lologog/TempControlBox/README.md

# TempControlBox - 🚧 Work in Progress
Device for testing control algorithms and system identification
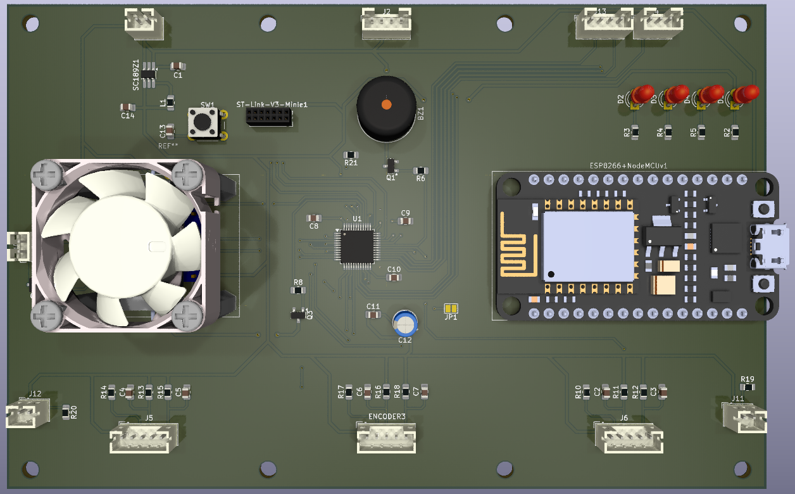
[picture p1: Images/TempControlBox-3D.png]

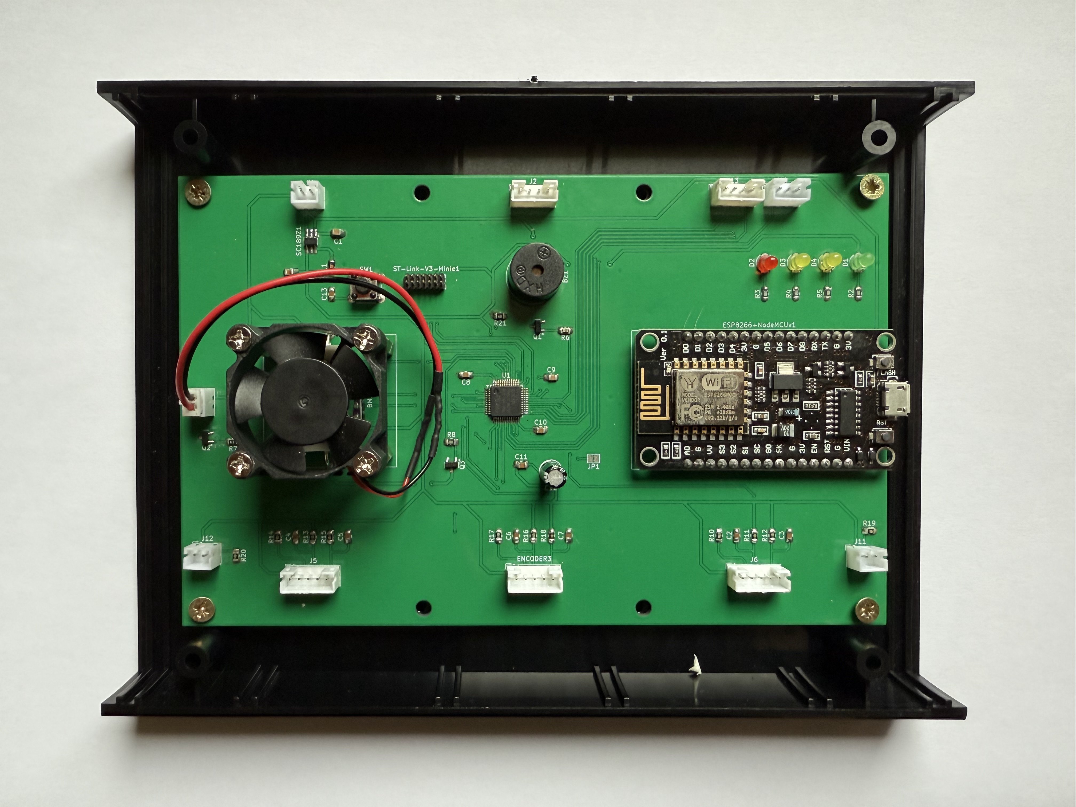
[picture p2: Images/TempControlBox-PCB.jpg]

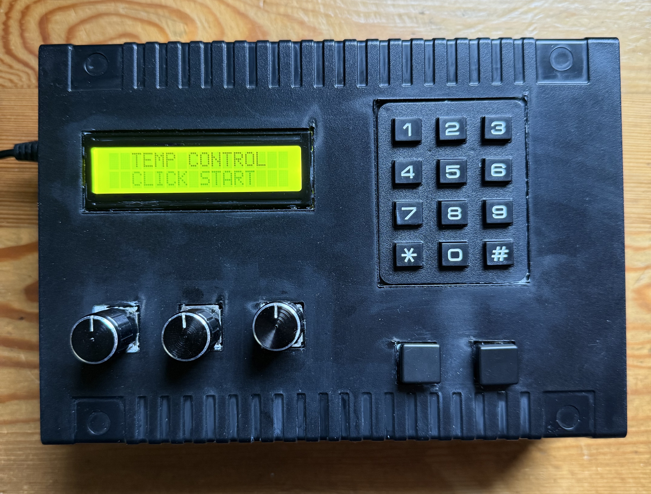
[picture p3: Images/TempControlBox-Assembled.jpg]
