lologog/TempControlBox/PCB/PID_TEMPERATURE_KICAD.kicad_pcb

## KiCad design PCB/PID_TEMPERATURE_KICAD.kicad_pcb (2025-03-09)

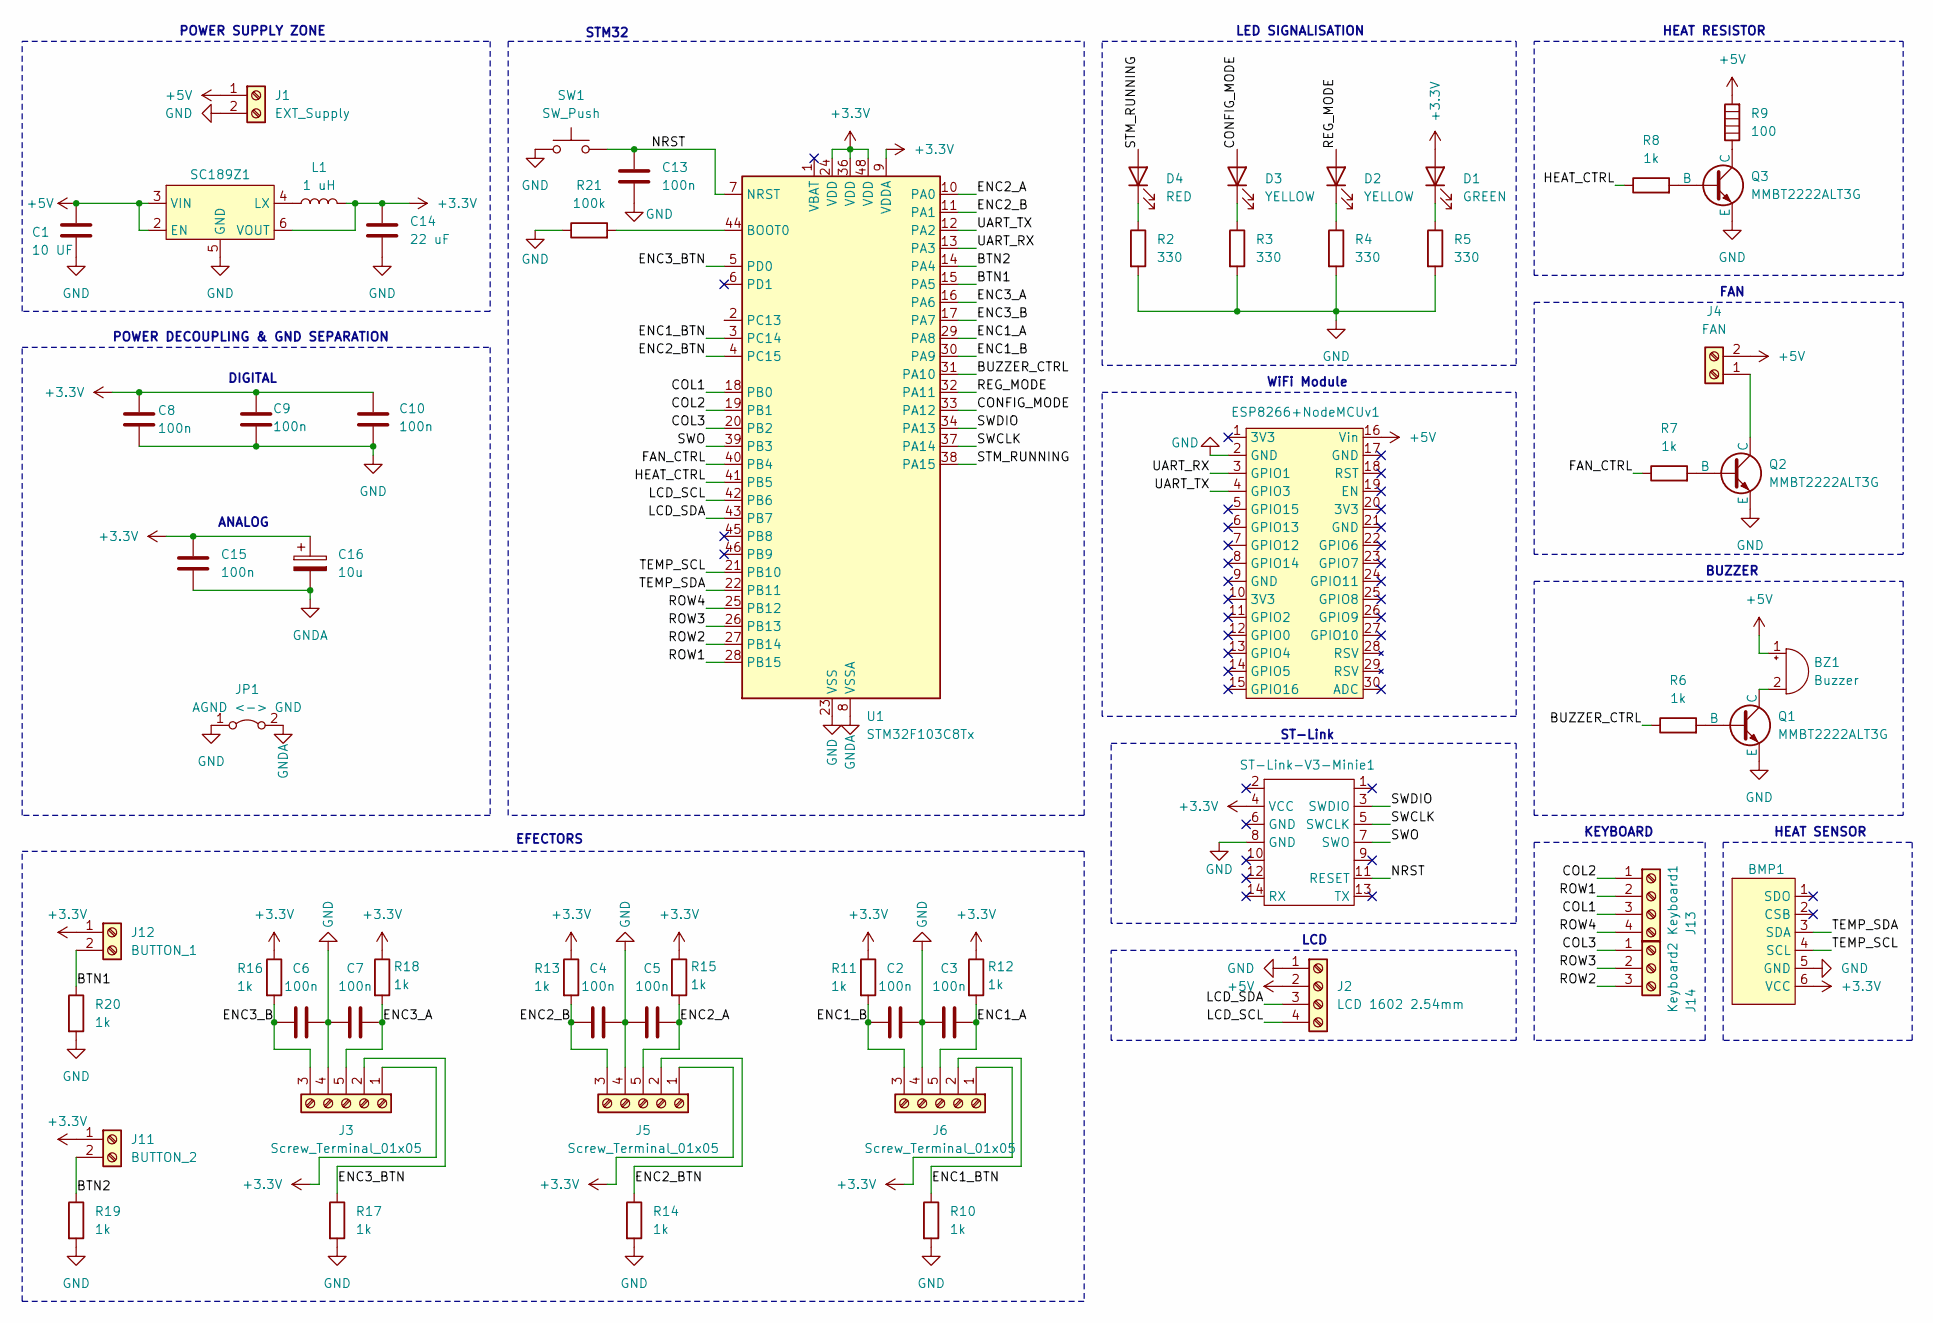
[picture p4: schematic PID_TEMPERATURE_KICAD.kicad_sch, TempControlBox]

Parts:
BMP1: BMP280
BZ1: Buzzer; Buzzer_12x9.5RM7.6
C1: 10 UF; C_0805_2012Metric_Pad1.18x1.45mm_HandSolder
C2, C3, C4, C5, C6, C7, C8, C9, C10, C13, C15: 100n; C_0805_2012Metric_Pad1.18x1.45mm_HandSolder
C14: 22 uF; C_0805_2012Metric_Pad1.18x1.45mm_HandSolder
C16: 10u; CP_Radial_D5.0mm_P2.50mm
D1: GREEN; LED_D3.0mm
D2, D3: YELLOW; LED_D3.0mm
D4: RED; LED_D3.0mm
ESP8266+NodeMCUv1: NodeMCU
J1: EXT_Supply; JST_PH_B2B-PH-K_1x02_P2.00mm_Vertical
J2: LCD 1602 2.54mm; JST_PH_B4B-PH-K_1x04_P2.00mm_Vertical
J3, J5, J6: Screw_Terminal_01x05; JST_PH_B5B-PH-K_1x05_P2.00mm_Vertical
J4: FAN; JST_PH_B2B-PH-K_1x02_P2.00mm_Vertical
J11: BUTTON_2; JST_PH_B2B-PH-K_1x02_P2.00mm_Vertical
J12: BUTTON_1; JST_PH_B2B-PH-K_1x02_P2.00mm_Vertical
J13: Keyboard1; JST_PH_B4B-PH-K_1x04_P2.00mm_Vertical
J14: Keyboard2; JST_PH_B3B-PH-K_1x03_P2.00mm_Vertical
JP1: AGND <-> GND; SolderJumper-2_P1.3mm_Bridged2Bar_Pad1.0x1.5mm
L1: 1 uH; R_0805_2012Metric_Pad1.20x1.40mm_HandSolder
Q1, Q2, Q3: MMBT2222ALT3G; SOT-23
R2, R3, R4, R5: 330; R_0805_2012Metric_Pad1.20x1.40mm_HandSolder
R6, R7, R8, R10, R11, R12, R13, R14, R15, R16, R17, R18, R19, R20: 1k; R_0805_2012Metric_Pad1.20x1.40mm_HandSolder
R9: 100; Heat_Resistor
R21: 100k; R_0805_2012Metric_Pad1.20x1.40mm_HandSolder
SC189Z1: TSOT-23-6_HandSoldering
ST-Link-V3-Minie1: PinSocket_2x07_P1.27mm_Vertical
SW1: SW_Push; SW_PUSH_6mm_H4.3mm
U1: STM32F103C8Tx; LQFP-48_7x7mm_P0.5mm

Connections:
+3.3V: BMP1.6 (VCC), C8.1, C9.1, C10.1, C14.1, C15.1, C16.1, D1.2 (A), J3.1, J5.1, J6.1, J11.1, J12.1, L1.2, R11.1, R12.1, R13.1, R15.1, R16.1, R18.1, SC189Z1.6 (VOUT), ST-Link-V3-Minie1.4 (VCC), U1.9 (VDDA), U1.24 (VDD), U1.36 (VDD), U1.48 (VDD)
+5V: BZ1.1 (+), C1.1, ESP8266+NodeMCUv1.16 (Vin), J1.1, J2.2, J4.2, R9.2, SC189Z1.2 (EN), SC189Z1.3 (VIN)
/BTN1: J12.2, R20.1, U1.15 (PA5)
/BTN2: J11.2, R19.1, U1.14 (PA4)
/BUZZER_CTRL: R6.1, U1.31 (PA10)
/COL1: J13.3, U1.18 (PB0)
/COL2: J13.1, U1.19 (PB1)
/COL3: J14.1, U1.20 (PB2)
/CONFIG_MODE: D3.2 (A), U1.33 (PA12)
/ENC1_A: C3.2, J6.5 (Pin_3), R12.2, U1.29 (PA8)
/ENC1_B: C2.1, J6.3 (Pin_5), R11.2, U1.30 (PA9)
/ENC1_BTN: J6.2, R10.1, U1.3 (PC14)
/ENC2_A: C5.2, J5.5 (Pin_3), R15.2, U1.10 (PA0)
/ENC2_B: C4.1, J5.3 (Pin_5), R13.2, U1.11 (PA1)
/ENC2_BTN: J5.2, R14.1, U1.4 (PC15)
/ENC3_A: C7.2, J3.5 (Pin_3), R18.2, U1.16 (PA6)
/ENC3_B: C6.1, J3.3 (Pin_5), R16.2, U1.17 (PA7)
/ENC3_BTN: J3.2, R17.1, U1.5 (PD0)
/FAN_CTRL: R7.1, U1.40 (PB4)
/HEAT_CTRL: R8.1, U1.41 (PB5)
/LCD_SCL: J2.4, U1.42 (PB6)
/LCD_SDA: J2.3, U1.43 (PB7)
/NRST: C13.1, ST-Link-V3-Minie1.11 (RESET), SW1.2, U1.7 (NRST)
/REG_MODE: D2.2 (A), U1.32 (PA11)
/ROW1: J13.2, U1.28 (PB15)
/ROW2: J14.3, U1.27 (PB14)
/ROW3: J14.2, U1.26 (PB13)
/ROW4: J13.4, U1.25 (PB12)
/STM_RUNNING: D4.2 (A), U1.38 (PA15)
/SWCLK: ST-Link-V3-Minie1.5 (SWCLK), U1.37 (PA14)
/SWDIO: ST-Link-V3-Minie1.3 (SWDIO), U1.34 (PA13)
/SWO: ST-Link-V3-Minie1.7 (SWO), U1.39 (PB3)
/TEMP_SCL: BMP1.4 (SCL), U1.21 (PB10)
/TEMP_SDA: BMP1.3 (SDA), U1.22 (PB11)
/UART_RX: ESP8266+NodeMCUv1.3 (GPIO1), U1.13 (PA3)
/UART_TX: ESP8266+NodeMCUv1.4 (GPIO3), U1.12 (PA2)
GND: BMP1.5 (GND), C1.2, C2.2, C3.1, C4.2, C5.1, C6.2, C7.1, C8.2, C9.2, C10.2, C13.2, C14.2, ESP8266+NodeMCUv1.2 (GND), J1.2, J2.1, J3.4, J5.4, J6.4, JP1.1 (A), Q1.2 (E), Q2.2 (E), Q3.2 (E), R2.2, R3.2, R4.2, R5.2, R10.2, R14.2, R17.2, R19.2, R20.2, R21.1, SC189Z1.5 (GND), ST-Link-V3-Minie1.8 (GND), SW1.1, U1.23 (VSS), U1.35 (VSS), U1.47 (VSS)
GNDA: C15.2, C16.2, JP1.2 (B), U1.8 (VSSA)
unnamed: BZ1.2 (-), Q1.3 (C)
unnamed: D1.1 (K), R5.1
unnamed: D2.1 (K), R4.1
unnamed: D3.1 (K), R3.1
unnamed: D4.1 (K), R2.1
unnamed: J4.1, Q2.3 (C)
unnamed: Q1.1 (B), R6.2
unnamed: Q2.1 (B), R7.2
unnamed: Q3.1 (B), R8.2
unnamed: Q3.3 (C), R9.1
unnamed: L1.1, SC189Z1.4 (LX)
unnamed: R21.2, U1.44 (BOOT0)

Notes on the sheet:
HEAT RESISTOR
ST-Link
EFECTORS
LCD
HEAT SENSOR
POWER DECOUPLING & GND SEPARATION
WiFi Module
BUZZER
ANALOG
STM32
LED SIGNALISATION
FAN
KEYBOARD
DIGITAL
POWER SUPPLY ZONE

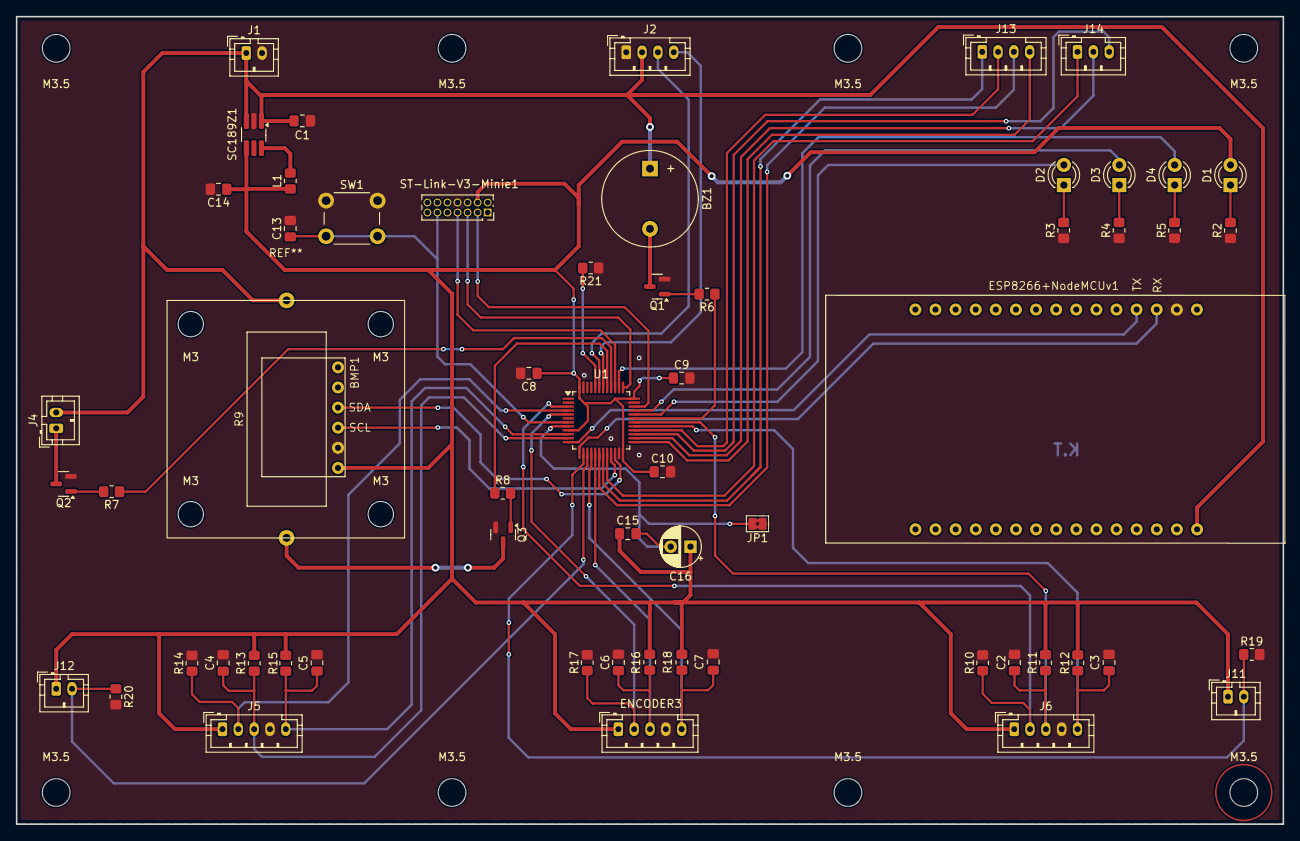
[picture p5: board PID_TEMPERATURE_KICAD.kicad_pcb from above]

Board: 2 copper layers, 160.0 x 102.0 mm, 72 parts (0 on the bottom side), 50 nets.

Other parts of the board:
M3, M3#2, M3#3, M3#4: MountingHole_3.2mm_M3
M3.5, M3.5#2, M3.5#3, M3.5#4, M3.5#5, M3.5#6, M3.5#7, M3.5#8: MountingHole_3.5mm
