lologog/TempControlBox/Firmware/STM32/Core/Src/main.c

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
/* Includes ------------------------------------------------------------------*/
#include "main.h"

/* USER CODE BEGIN Includes */
#include "lcd1602.h"
#include "keyboard.h"
#include "tempsensor.h"
#include "logic.h"
/* USER CODE END Includes */

I2C_HandleTypeDef hi2c1;
I2C_HandleTypeDef hi2c2;

TIM_HandleTypeDef htim1;
TIM_HandleTypeDef htim2;
TIM_HandleTypeDef htim3;

UART_HandleTypeDef huart2;

void SystemClock_Config(void);
static void MX_GPIO_Init(void);
static void MX_I2C1_Init(void);
static void MX_TIM1_Init(void);
static void MX_TIM2_Init(void);
static void MX_TIM3_Init(void);
static void MX_I2C2_Init(void);
static void MX_USART2_UART_Init(void);
/* USER CODE BEGIN 0 */
void HAL_GPIO_EXTI_Callback(uint16_t GPIO_Pin)
{
    if (GPIO_Pin == BTN2_Pin)
    {
        NVIC_SystemReset(); // Reset the system
    }
}
/* USER CODE END 0 */

/**
  * @brief  The application entry point.
  * @retval int
  */
int main(void)
{

  /* MCU Configuration--------------------------------------------------------*/

  /* Reset of all peripherals, Initializes the Flash interface and the Systick. */
  HAL_Init();

  /* Configure the system clock */
  SystemClock_Config();

  /* Initialize all configured peripherals */
  MX_GPIO_Init();
  MX_I2C1_Init();
  MX_TIM1_Init();
  MX_TIM2_Init();
  MX_TIM3_Init();
  MX_I2C2_Init();
  MX_USART2_UART_Init();
  /* USER CODE BEGIN 2 */
  //initialization of the peripherials and its necessaries
  HAL_TIM_Encoder_Start(&htim1, TIM_CHANNEL_ALL);
  HAL_TIM_Encoder_Start(&htim2, TIM_CHANNEL_ALL);
  HAL_TIM_Encoder_Start(&htim3, TIM_CHANNEL_ALL);
  TempSensor_Init(&hi2c2);
  LCD_Init(&hi2c1);

  //turn on the LED that shows that STM is working
  HAL_GPIO_WritePin(STM_RUNNING_GPIO_Port, STM_RUNNING_Pin, GPIO_PIN_SET);

  /* USER CODE END 2 */

  /* Infinite loop */
  /* USER CODE BEGIN WHILE */
  while (1)
  {
    stateMachine();
    /* USER CODE END WHILE */

    /* USER CODE BEGIN 3 */
  }
  /* USER CODE END 3 */
}

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
