lologog/TempControlBox/Firmware/STM32/Core/Inc/main.h

#define ENC1_BTN_Pin GPIO_PIN_14
#define ENC1_BTN_GPIO_Port GPIOC
#define ENC2_BTN_Pin GPIO_PIN_15
#define ENC2_BTN_GPIO_Port GPIOC
#define ENC3_BTN_Pin GPIO_PIN_0
#define ENC3_BTN_GPIO_Port GPIOD
#define ENC2_A_Pin GPIO_PIN_0
#define ENC2_A_GPIO_Port GPIOA
#define ENC2_B_Pin GPIO_PIN_1
#define ENC2_B_GPIO_Port GPIOA
#define UART_TX_Pin GPIO_PIN_2
#define UART_TX_GPIO_Port GPIOA
#define UART_RX_Pin GPIO_PIN_3
#define UART_RX_GPIO_Port GPIOA
#define BTN2_Pin GPIO_PIN_4
#define BTN2_GPIO_Port GPIOA
#define BTN2_EXTI_IRQn EXTI4_IRQn
#define BTN1_Pin GPIO_PIN_5
#define BTN1_GPIO_Port GPIOA
#define ENC3_A_Pin GPIO_PIN_6
#define ENC3_A_GPIO_Port GPIOA
#define ENC3_B_Pin GPIO_PIN_7
#define ENC3_B_GPIO_Port GPIOA
#define COL1_Pin GPIO_PIN_0
#define COL1_GPIO_Port GPIOB
#define COL2_Pin GPIO_PIN_1
#define COL2_GPIO_Port GPIOB
#define COL3_Pin GPIO_PIN_2
#define COL3_GPIO_Port GPIOB
#define TEMP_SCL_Pin GPIO_PIN_10
#define TEMP_SCL_GPIO_Port GPIOB
#define TEMP_SDA_Pin GPIO_PIN_11
#define TEMP_SDA_GPIO_Port GPIOB
#define ROW4_Pin GPIO_PIN_12
#define ROW4_GPIO_Port GPIOB
#define ROW3_Pin GPIO_PIN_13
#define ROW3_GPIO_Port GPIOB
#define ROW2_Pin GPIO_PIN_14
#define ROW2_GPIO_Port GPIOB
#define ROW1_Pin GPIO_PIN_15
#define ROW1_GPIO_Port GPIOB
#define ENC1_A_Pin GPIO_PIN_8
#define ENC1_A_GPIO_Port GPIOA
#define ENC1_B_Pin GPIO_PIN_9
#define ENC1_B_GPIO_Port GPIOA
#define BUZZER_CTRL_Pin GPIO_PIN_10
#define BUZZER_CTRL_GPIO_Port GPIOA
#define REG_MODE_Pin GPIO_PIN_11
#define REG_MODE_GPIO_Port GPIOA
#define CONFIG_MODE_Pin GPIO_PIN_12
#define CONFIG_MODE_GPIO_Port GPIOA
#define SWDIO_Pin GPIO_PIN_13
#define SWDIO_GPIO_Port GPIOA
#define SWCLK_Pin GPIO_PIN_14
#define SWCLK_GPIO_Port GPIOA
#define STM_RUNNING_Pin GPIO_PIN_15
#define STM_RUNNING_GPIO_Port GPIOA
#define FAN_CTRL_Pin GPIO_PIN_4
#define FAN_CTRL_GPIO_Port GPIOB
#define HEAT_CTRL_Pin GPIO_PIN_5
#define HEAT_CTRL_GPIO_Port GPIOB
#define LCD_SCL_Pin GPIO_PIN_6
#define LCD_SCL_GPIO_Port GPIOB
#define LCD_SDA_Pin GPIO_PIN_7
#define LCD_SDA_GPIO_Port GPIOB
