lologog/TempControlBox/Firmware/STM32/Core/Src/keyboard.c

/*
 * keyboard.c
 *
 *  Created on: Dec 2, 2024
 *      Author: Krzysztof Tomicki
 */

#include "keyboard.h"

// Table of all keys on the keyboard
const char keyMap[4][3] = {
		{'1', '2', '3'}, //Row 1
		{'4', '5', '6'}, //Row 2
		{'7', '8', '9'}, //Row 3
		{'.', '0', '#'}  //Row 4
};

// Function to read the pressed key
char Keyboard_readKey(void)
{
    // Add a small delay to ensure stable readings
    HAL_Delay(10);
    
    for (int row = 0; row < 4; row++) {
        // Set all rows to HIGH initially
        HAL_GPIO_WritePin(ROW1_GPIO_Port, ROW1_Pin, GPIO_PIN_SET);
        HAL_GPIO_WritePin(ROW2_GPIO_Port, ROW2_Pin, GPIO_PIN_SET);
        HAL_GPIO_WritePin(ROW3_GPIO_Port, ROW3_Pin, GPIO_PIN_SET);
        HAL_GPIO_WritePin(ROW4_GPIO_Port, ROW4_Pin, GPIO_PIN_SET);
        
        // Short delay for pins to stabilize
        HAL_Delay(1);
        
        // Set only one row to LOW
        if (row == 0) HAL_GPIO_WritePin(ROW1_GPIO_Port, ROW1_Pin, GPIO_PIN_RESET);
        else if (row == 1) HAL_GPIO_WritePin(ROW2_GPIO_Port, ROW2_Pin, GPIO_PIN_RESET);
        else if (row == 2) HAL_GPIO_WritePin(ROW3_GPIO_Port, ROW3_Pin, GPIO_PIN_RESET);
        else if (row == 3) HAL_GPIO_WritePin(ROW4_GPIO_Port, ROW4_Pin, GPIO_PIN_RESET);
        
        // Short delay for pins to stabilize
        HAL_Delay(1);

        // Check columns for the current row
        if (HAL_GPIO_ReadPin(COL1_GPIO_Port, COL1_Pin) == GPIO_PIN_RESET) return keyMap[row][0];
        if (HAL_GPIO_ReadPin(COL2_GPIO_Port, COL2_Pin) == GPIO_PIN_RESET) return keyMap[row][1];
        if (HAL_GPIO_ReadPin(COL3_GPIO_Port, COL3_Pin) == GPIO_PIN_RESET) return keyMap[row][2];
    }

    // if no key is pressed, return '\0'
    return '\0';
}
