lologog/TempControlBox/(commit log)

2025-03-03 project: add 3D render of the PCB to images
2025-03-03 project: add stm32 StateMachine project files
2025-03-03 project: add PCB and schematic to PCB folder
    [PID_TEMPERATURE_KICAD.kicad_pcb, PID_TEMPERATURE_KICAD.kicad_sch]
2025-03-03 project: fixing LED color description
    [PID_TEMPERATURE_KICAD.kicad_sch]
2025-03-04 project: add working LEDs
2025-03-04 project: add 2 buttons to the project
2025-03-04 Revert "Merge pull request #1 from lologog/dev"
    This reverts commit 592201721d847cee020b1f18eabaf14be8bc48c8, reversing
    changes made to 8926a7ebba7f131fc6c6466d1f3102db8be0bb79.
    [StateMachine.ioc, main.c, main.h]
2025-03-04 project: add 3 encoder buttons to the project
2025-03-04 project: fixing conflicts during merging to main
    [main.c, main.h]
2025-03-04 project: add working Keyboard library and pin setup
2025-03-05 project: add PCB and Box photos to the Images folder
2025-03-05 README: add PCB and Box photos
2025-03-06 project: add working encoders
2025-03-06 project: commit in main with clean code for encoders
2025-03-06 project: add temperature reading via I2C with self-created libraries
2025-03-07 project: add UART configuration to STM
2025-03-07 project: add reset program interrupt button
    [StateMachine.ioc, main.c, main.h]
2025-03-09 Project: add LED that shows that STM is running correctly
    [main.c]
2025-03-09 Project: fixing LED names order
    [PID_TEMPERATURE_KICAD.kicad_pcb, PID_TEMPERATURE_KICAD.kicad_sch]
2025-03-09 Project: aesthetic correctons in STATE_INIT
    [logic.c]
2025-03-15 Project: add WRONG NUMBER information if wrong number is chosen
    [logic.c]
2025-03-15 Project: small improvements in error message code
    [logic.c]
2025-03-21 Project: fixed bug with floating 'wrong number' after 2 sec
    [logic.c]
2025-03-21 Project: fixed bug and now user has to enter all digits before going into next state
    [logic.c]
2025-03-21 Project: removing automatically dot - too much uncomfortable
    [logic.c]
2025-09-07 Project: Convert from STM32CubeIDE into VSCode
2025-09-07 Project: add state to choose control type, upgrade keyboard library and handle STM ok LED in main
